cluoma/GliderWing/WingAileron.step

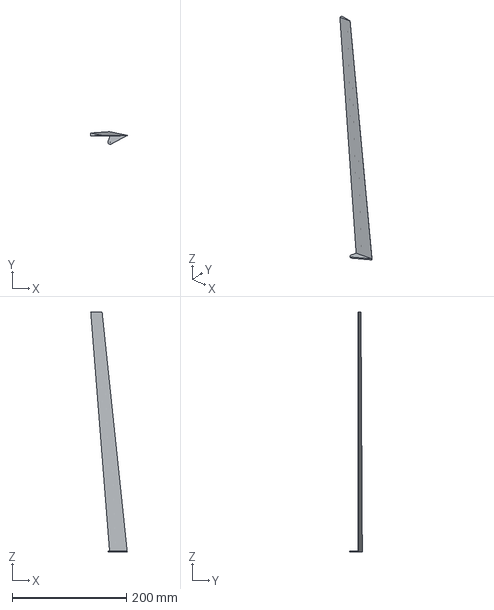
[picture p1: CAD file, 2026-10-26]
WingAileron.step
64.0 x 22.2 x 420.0 mm
