cluoma/GliderWing/MegaWing.3mf

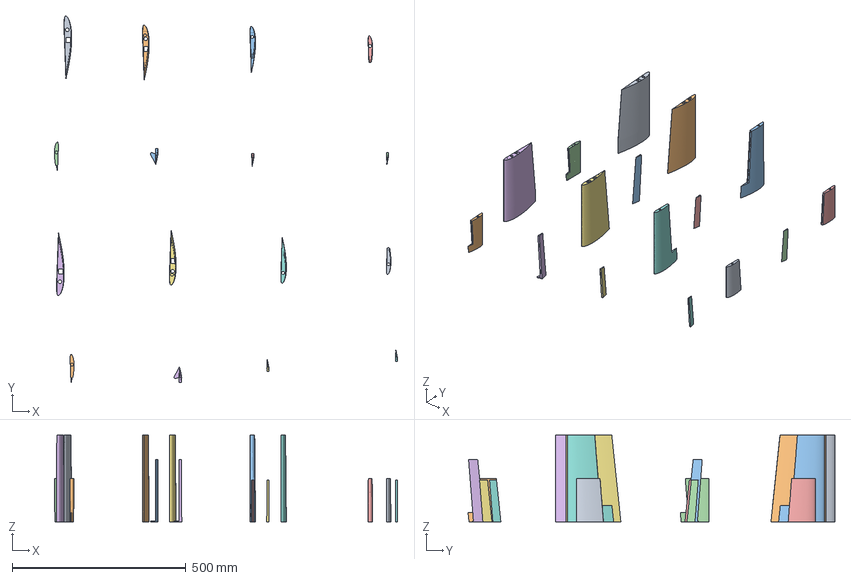
[picture p2: CAD file, 2026-10-26]
MegaWing.3mf
988.2 x 1056.9 x 250.0 mm
WingBody.step_B x 2
WingBody.step_A_B x 2
WingBody.step_A_A_B x 2
WingBody.step_A_A_A_A x 2
WingBody.step_A_A_A_B x 2
WingAileron.step_B x 2
WingAileron.step_A_A x 2
WingAileron.step_A_B x 2
