cluoma/GliderWing/WingBody.step

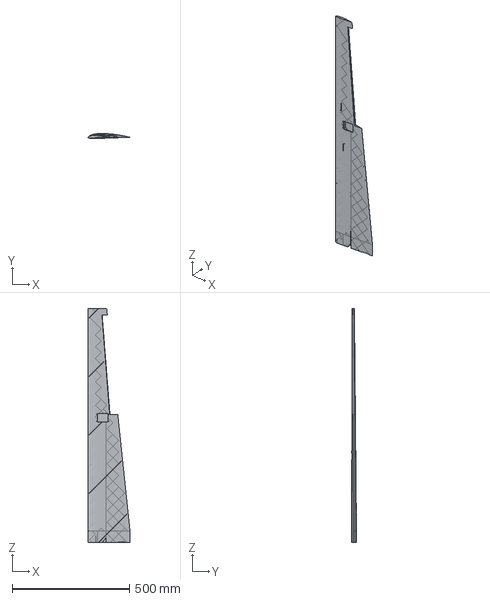
[picture p3: CAD file, 2026-10-26]
WingBody.step
179.5 x 21.9 x 1000.0 mm
