cluoma/GliderWing/(list of files, cad)

Other CAD files:
GliderWing-Aileron.stl
GliderWing-Wing.stl
